mouyuhua/MFly/开题答辩问题.md

1. 选用NRF2401的优势在哪里

NRF2401的通信频段在2.4G，这个频段抗干扰能力强，可以远距离传输，最大传输距离可达10米。此外，NRF2401相比于其他通信，有着更好的安全性。所以选用NRF2401可以保证四轴飞行器的远距离安全飞行。

2. 为什么采用PWM的方式调节电机转速

利用PWM可以实现从处理器到被控系统号都是数字形式的，无需进行数模转换。让信号保持为数字形式可将噪声影响降到最小。从而可以更加精确的控制电机的转速，确保四轴飞行器飞行过程中保持平稳。

3. 为什么选用MPU9250，而不选用MPU6050

MPU6050是六轴传感器，包含了三轴加速度和三轴陀螺仪。而MPU9250相比于MPU6050多了三轴的磁力计。可以利用三轴磁力计可以更加精确的计算出四轴飞行器的状态。因此利用MPU9250比利用MPU6050来控制四轴更加有优势。
