mouyuhua/MFly/PCB_原理图/Project Outputs for Fly_Project/清单.xls

Comment | Description | Designator | Footprint | LibRef | Value
Type_c-16P |  | *1 | TYPE-C-16P | Type_c-16P
BAT | Header, 2-Pin | Battery1 | BAT | BAT
1uf |  | C1, C5, C6, C7, C8, C28, C29, C30, C31 | 0603P | C | 1uf
15pF |  | C2 | 0603P | C | 15pF
22uF |  | C3, C4, C9, C33 | 0603P | C | 22uF
10nF |  | C10, C22 | 0603P | C | 10nF
1nF |  | C11 | 0603P | C | 1nF
3.3nF |  | C12 | 0603P | C | 3.3nF
1.5pF |  | C13 | 0603P | C | 1.5pF
1pF |  | C14 | 0603P | C | 1pF
2.2nF |  | C15 | 0603P | C | 2.2nF
4.7pF |  | C16 | 0603P | C | 4.7pF
10pF |  | C17, C18 | 0603P | C | 10pF
0.1uF |  | C19, C20, C21, C23, C32, C34, C35, C36, C37, C38, C40 | 0603P | C | 0.1uF
10uF |  | C24, C25, C26, C27 | 0603P | C | 10uF
LED_0603 | 发光二极管 | D1, D4, D11 | LED-0603 | LED 0603
BAT54C | 表贴肖特基二极管 | D2 | SOT23-3M | BAT54C
DIODE | 普通二极管 | D3 | SMA/DO-214AC | DIODE
1N4148 |  | D5, D6, D7, D8 | DIODE_SOP | D
P923D |  | D9, D10, D12, D13 | RGB_LED_5050 | P923D
ANT |  | E1 | ANT | ANT
LTC4054ES5-4.2 | 锂电池充电芯片 | IC1 | SOT23-5M | LTC4054
Pin HDR1X8 |  | J1, J2 | Pin HDR1X8/2.54mm-S | Pin HDR1X8
INDUCTOR | INDUCTOR | L1 | AL0204 | INDUCTOR
INDUCTOR | INDUCTOR | L2, L3, L4 | 0402L | INDUCTOR
Motor_720 | Motor, General Kind | M1, M2, M3, M4 | MOTOR | Motor_720
Header 1 |  | P1, P2, P3, P4, P5 | HEADER1 | Header 1
Header 4 | Header, 4-Pin | P6 | HDR1X4 | Header 4
SI2302 | N-Channel Power MOSFET | Q1, Q2, Q3, Q4 | SOT23-3M | SI2302
AO3401 | MOS管_P沟道 | Q5 | SOT23-3M | MOSFET-P
SS9013 | 8050/BCW846/BCW847 | Q6 | SOT-23R | NPN
2.2K |  | R1 | 0603P | R | 2.2K
1K |  | R2, R18, R19, R22, R23 | 0603P | R | 1K
22R |  | R3, R6 | 0603P | R | 22R
4.7K |  | R4, R10, R16, R17 | 0603P | R | 4.7K
10K |  | R5, R9, R20, R21, R24, R25, R27, R29, R33, R34, R35, R36 | 0603P | R | 10K
73.2K |  | R7 | 0603P | R | 73.2K
100K |  | R8, R11, R12, R30, R31, R32 | 0603P | R | 100K
22K |  | R13 | 0603P | R | 22K
0 |  | R14, R15, R26, R28 | 0603P | R | 0
KEY_M |  | RESET? | KEY_M | KEY_M
SW-SPDT | SPDT Subminiature Toggle Switch, Right Angle Mounting, Vertical Actuation | S1 | SWITCH_PWR | SW-SPDT
SX1308 | 可调升压芯片 | U1 | SOT23-6 | SX1308
XC6206 |  | U2, U3 | SOT23-3M | XC6206
nRF24L01 |  | U4 | QFN20 | nRF24L01
FBM320\BMP280\SPL06 | 气压计 | U5, U7 | LGA-2_5X2MM | FBM320
MPU9250 | MPU9250 | U6 | QFN24-0.4 | MPU9250
ESP8266 |  | U8 | ESP_12 | ESP8266
STM32F103C8T6 |  | U9 | LQFP48 7X7 | STM32F103C8T6
XTAL | XTAL16M | XTAL1 | SMD-3225_4P | XTAL16M | 16MHz
XTAL |  | Y1 | SMD-cstse800G52-r0 | XTAL_2 | 8MHz
