mouyuhua/MFly/(list of files, cad)

Other CAD files:
PCB_原理图/mfly_shape.dwg
