mouyuhua/MFly/PCB_原理图/Project Outputs for Fly_Project/MFly.pdf

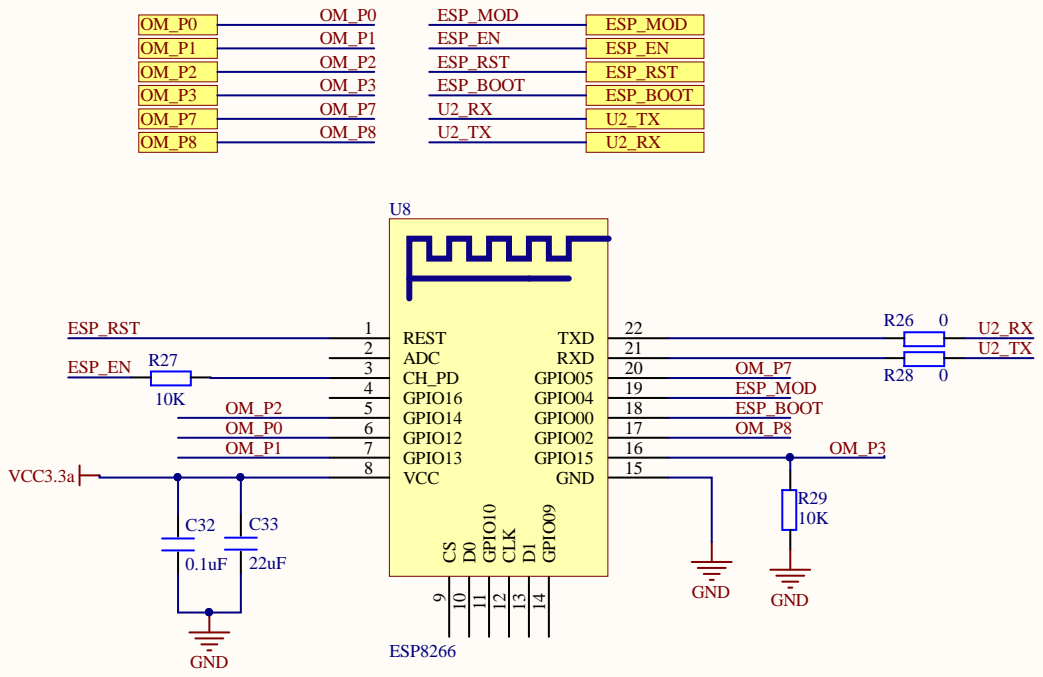
[picture p4: page 1]

GPIO13 7
VCC 8

Title | Altium Limited L3, 12a Rodborough Rd Frenchs Forest NSW Australia 2086

Size: A3 | Number: | Revision:
Date: 2022/4/23 Time: 13:10:14 | | Sheet of

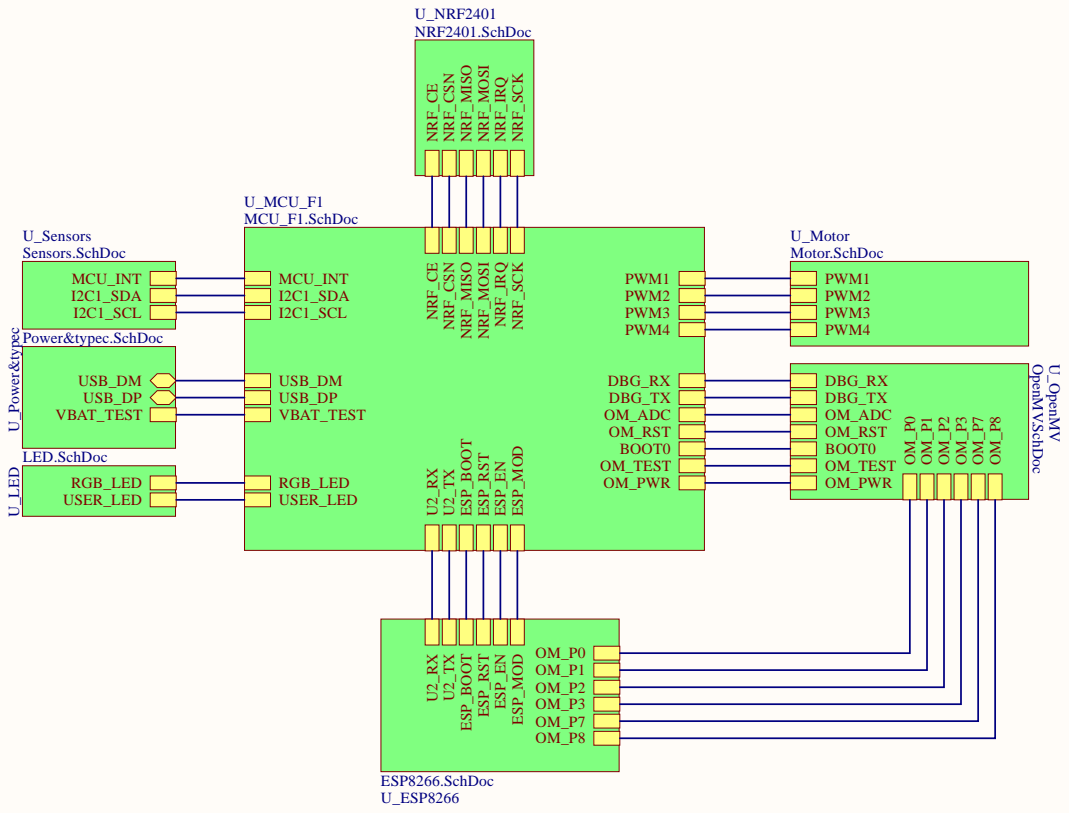
[picture p5: page 2]

U_Power&typec Power&typec.SchDoc

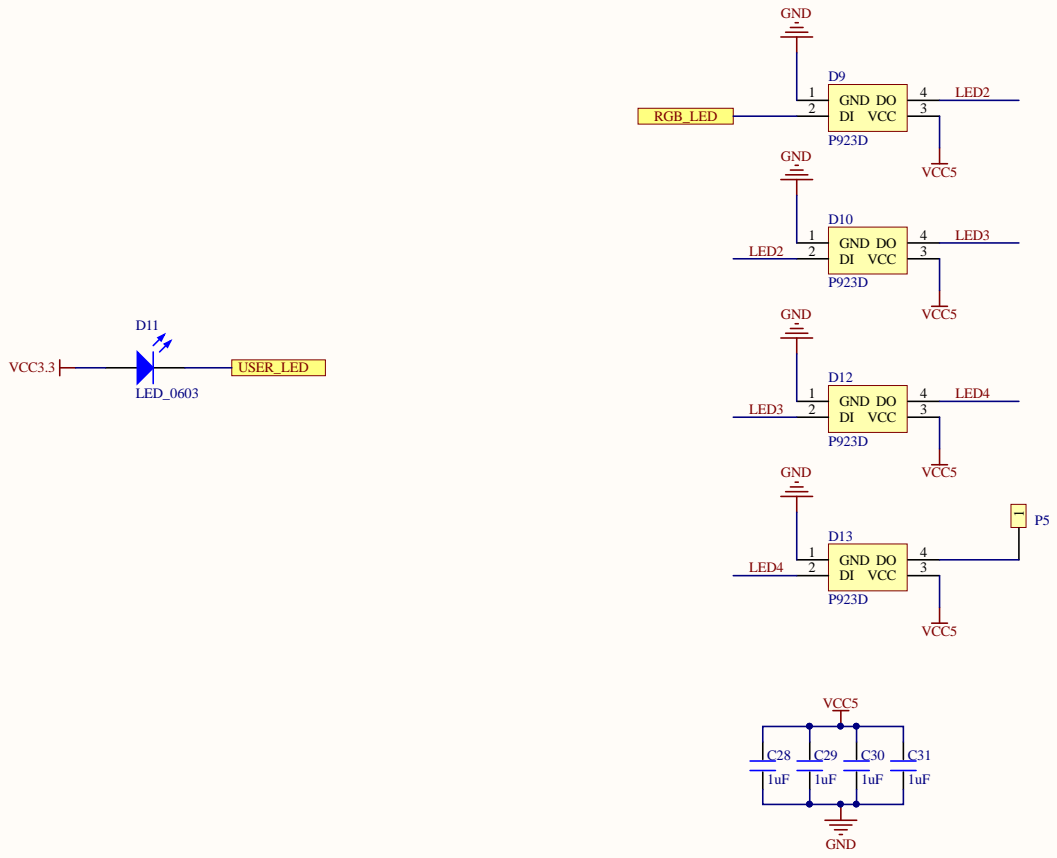
[picture p6: page 3]

Australia 2086

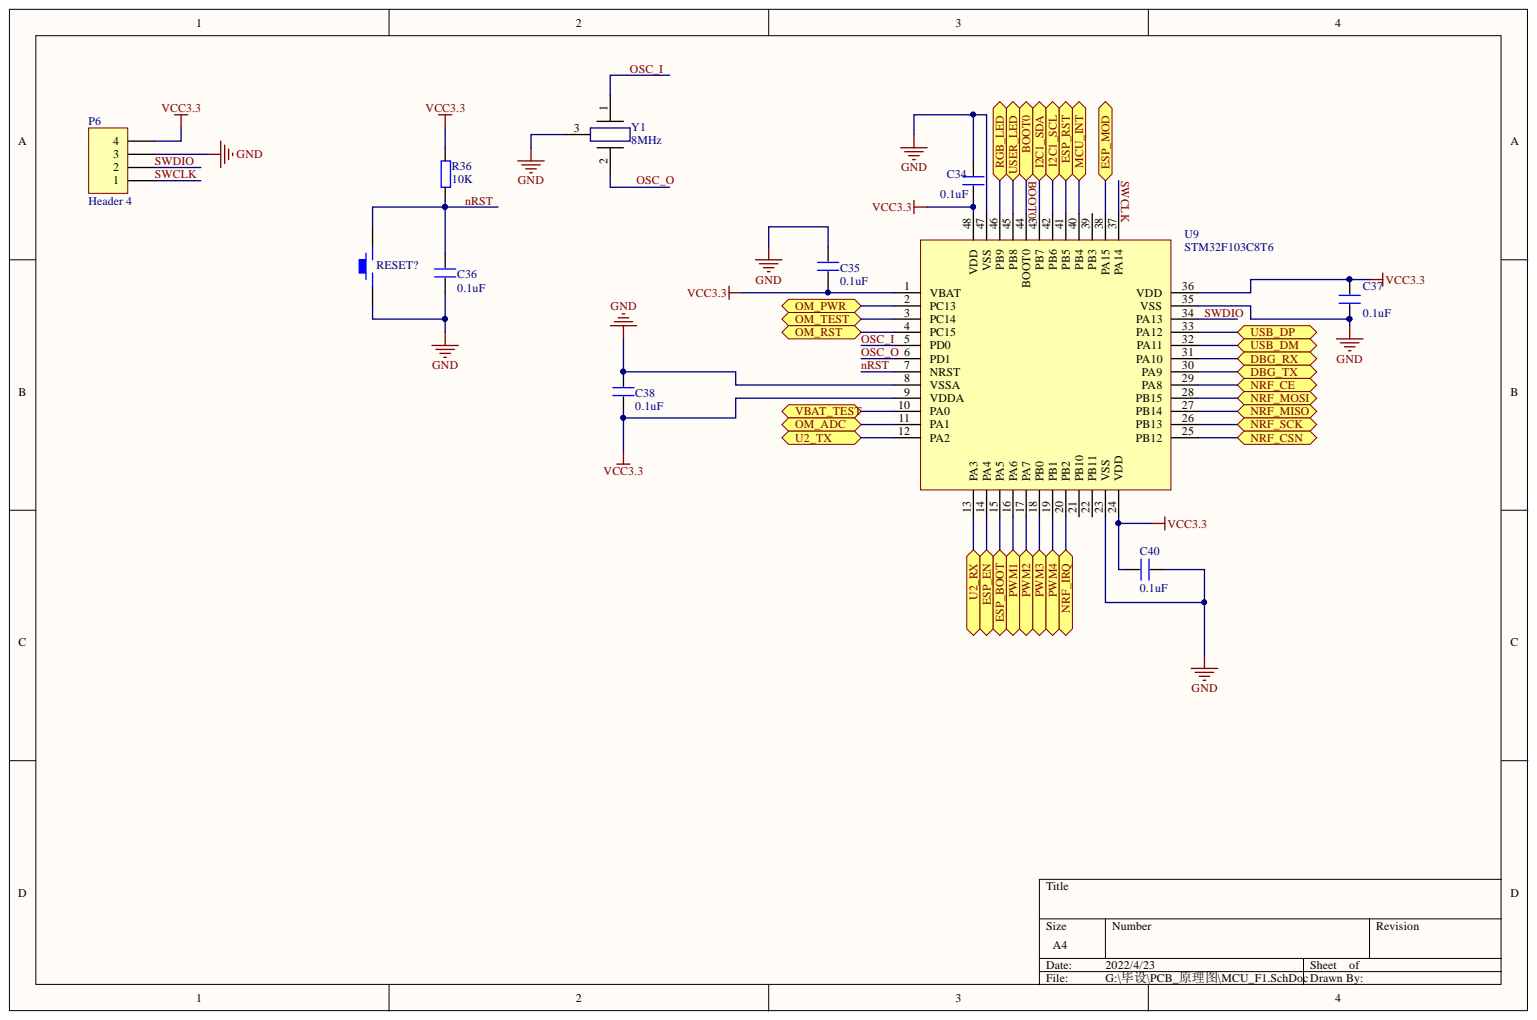
[picture p7: page 4]

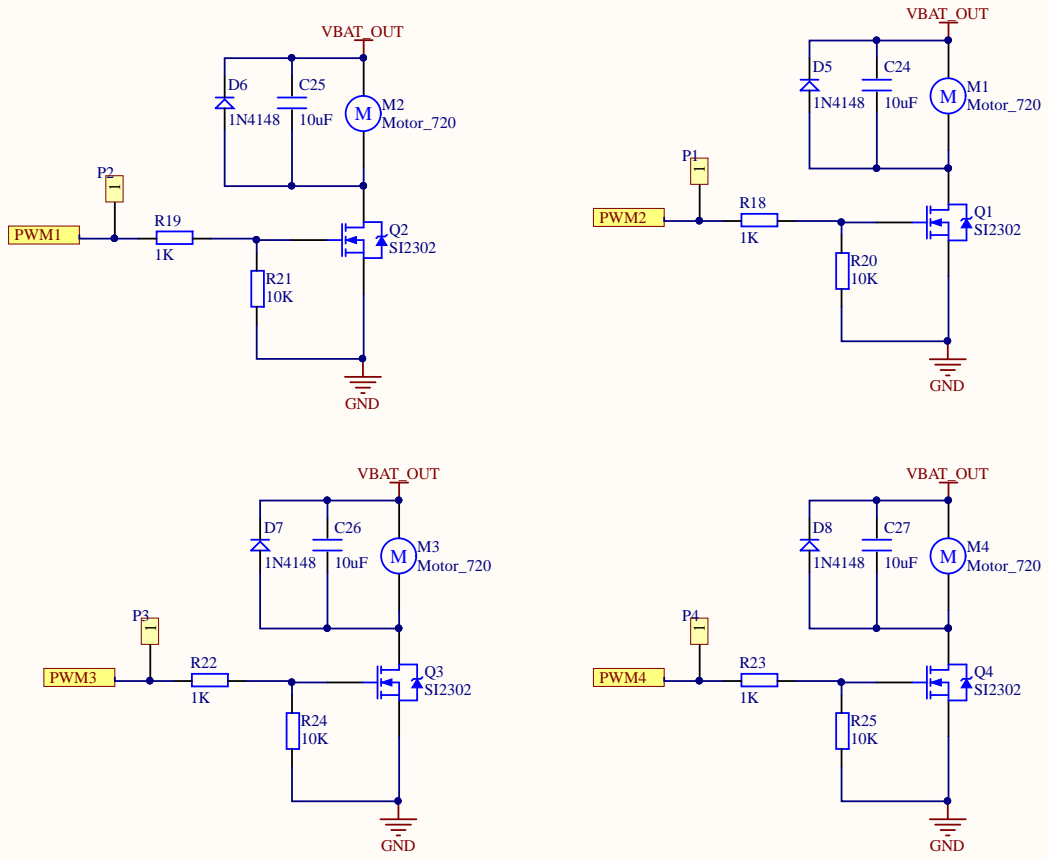
[picture p8: page 5]

Australia 2086

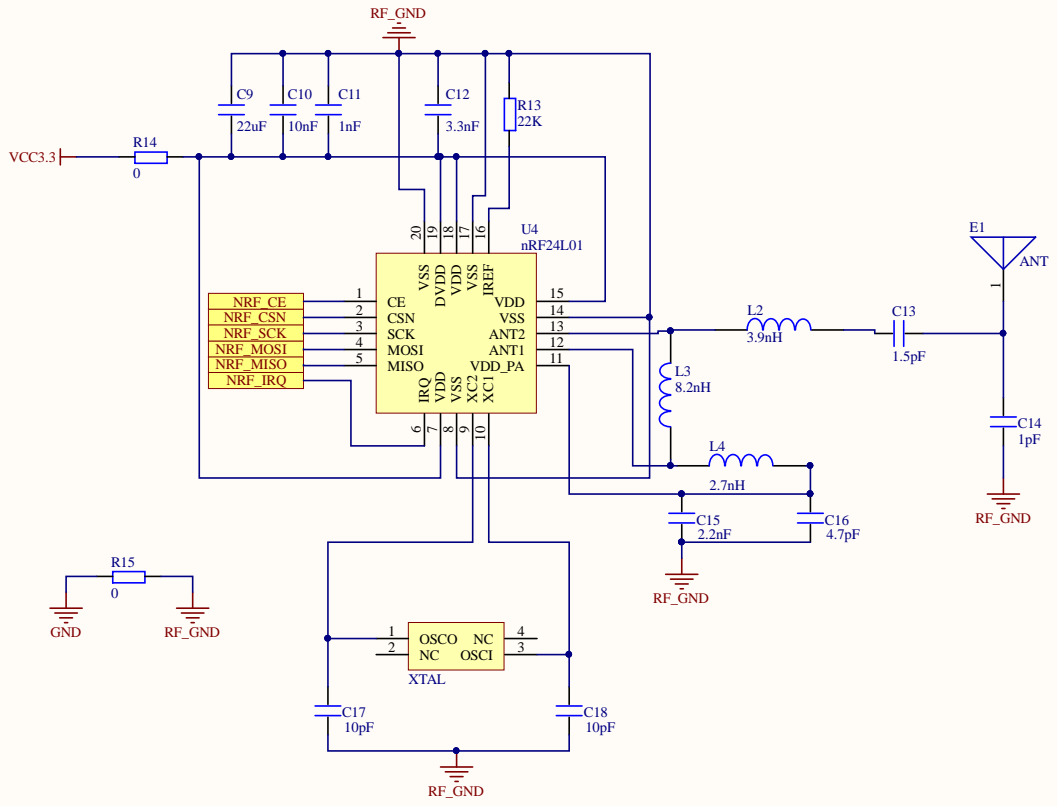
[picture p9: page 6]

15 REF 16 VSS 17 VDD 18 DVDD 19 VSS 20

NRF_CE | CSN 2

Australia 2086

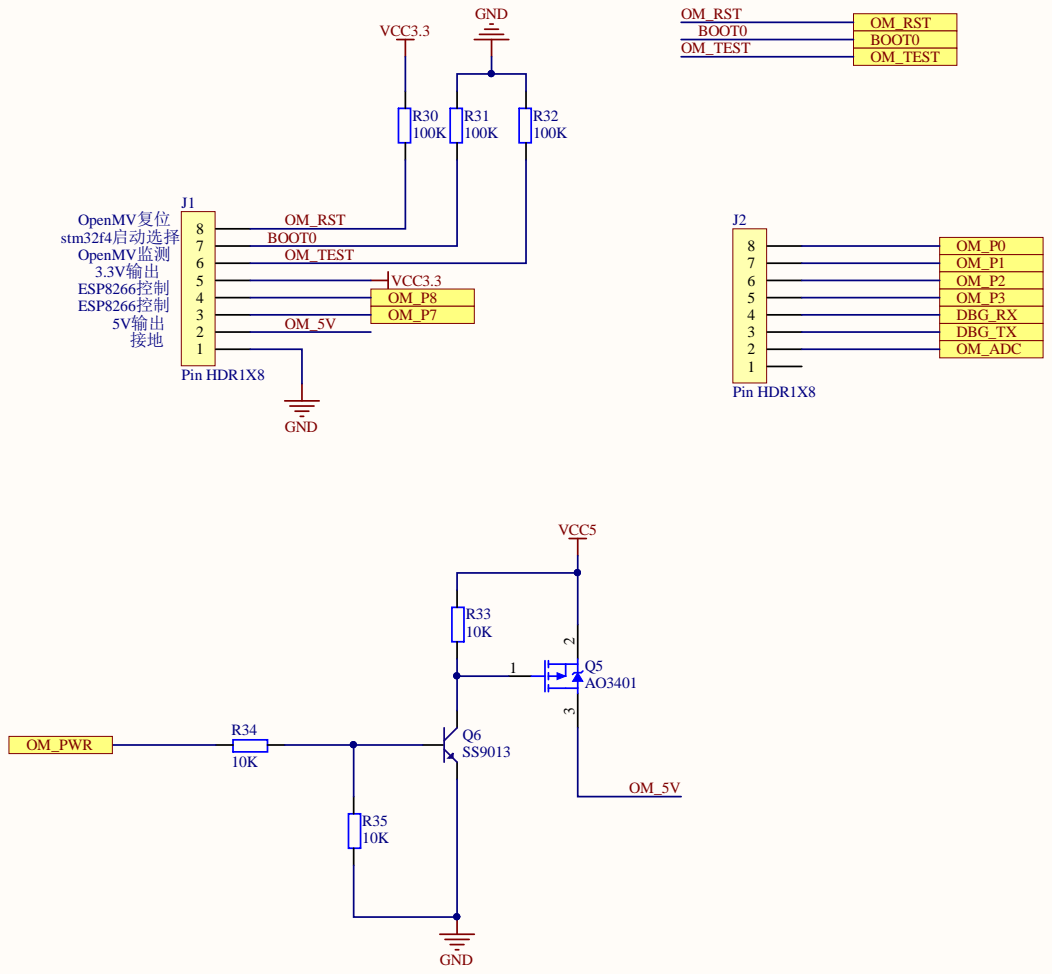
[picture p10: page 7]

VCC3.3 | OM_P1

Australia 2086

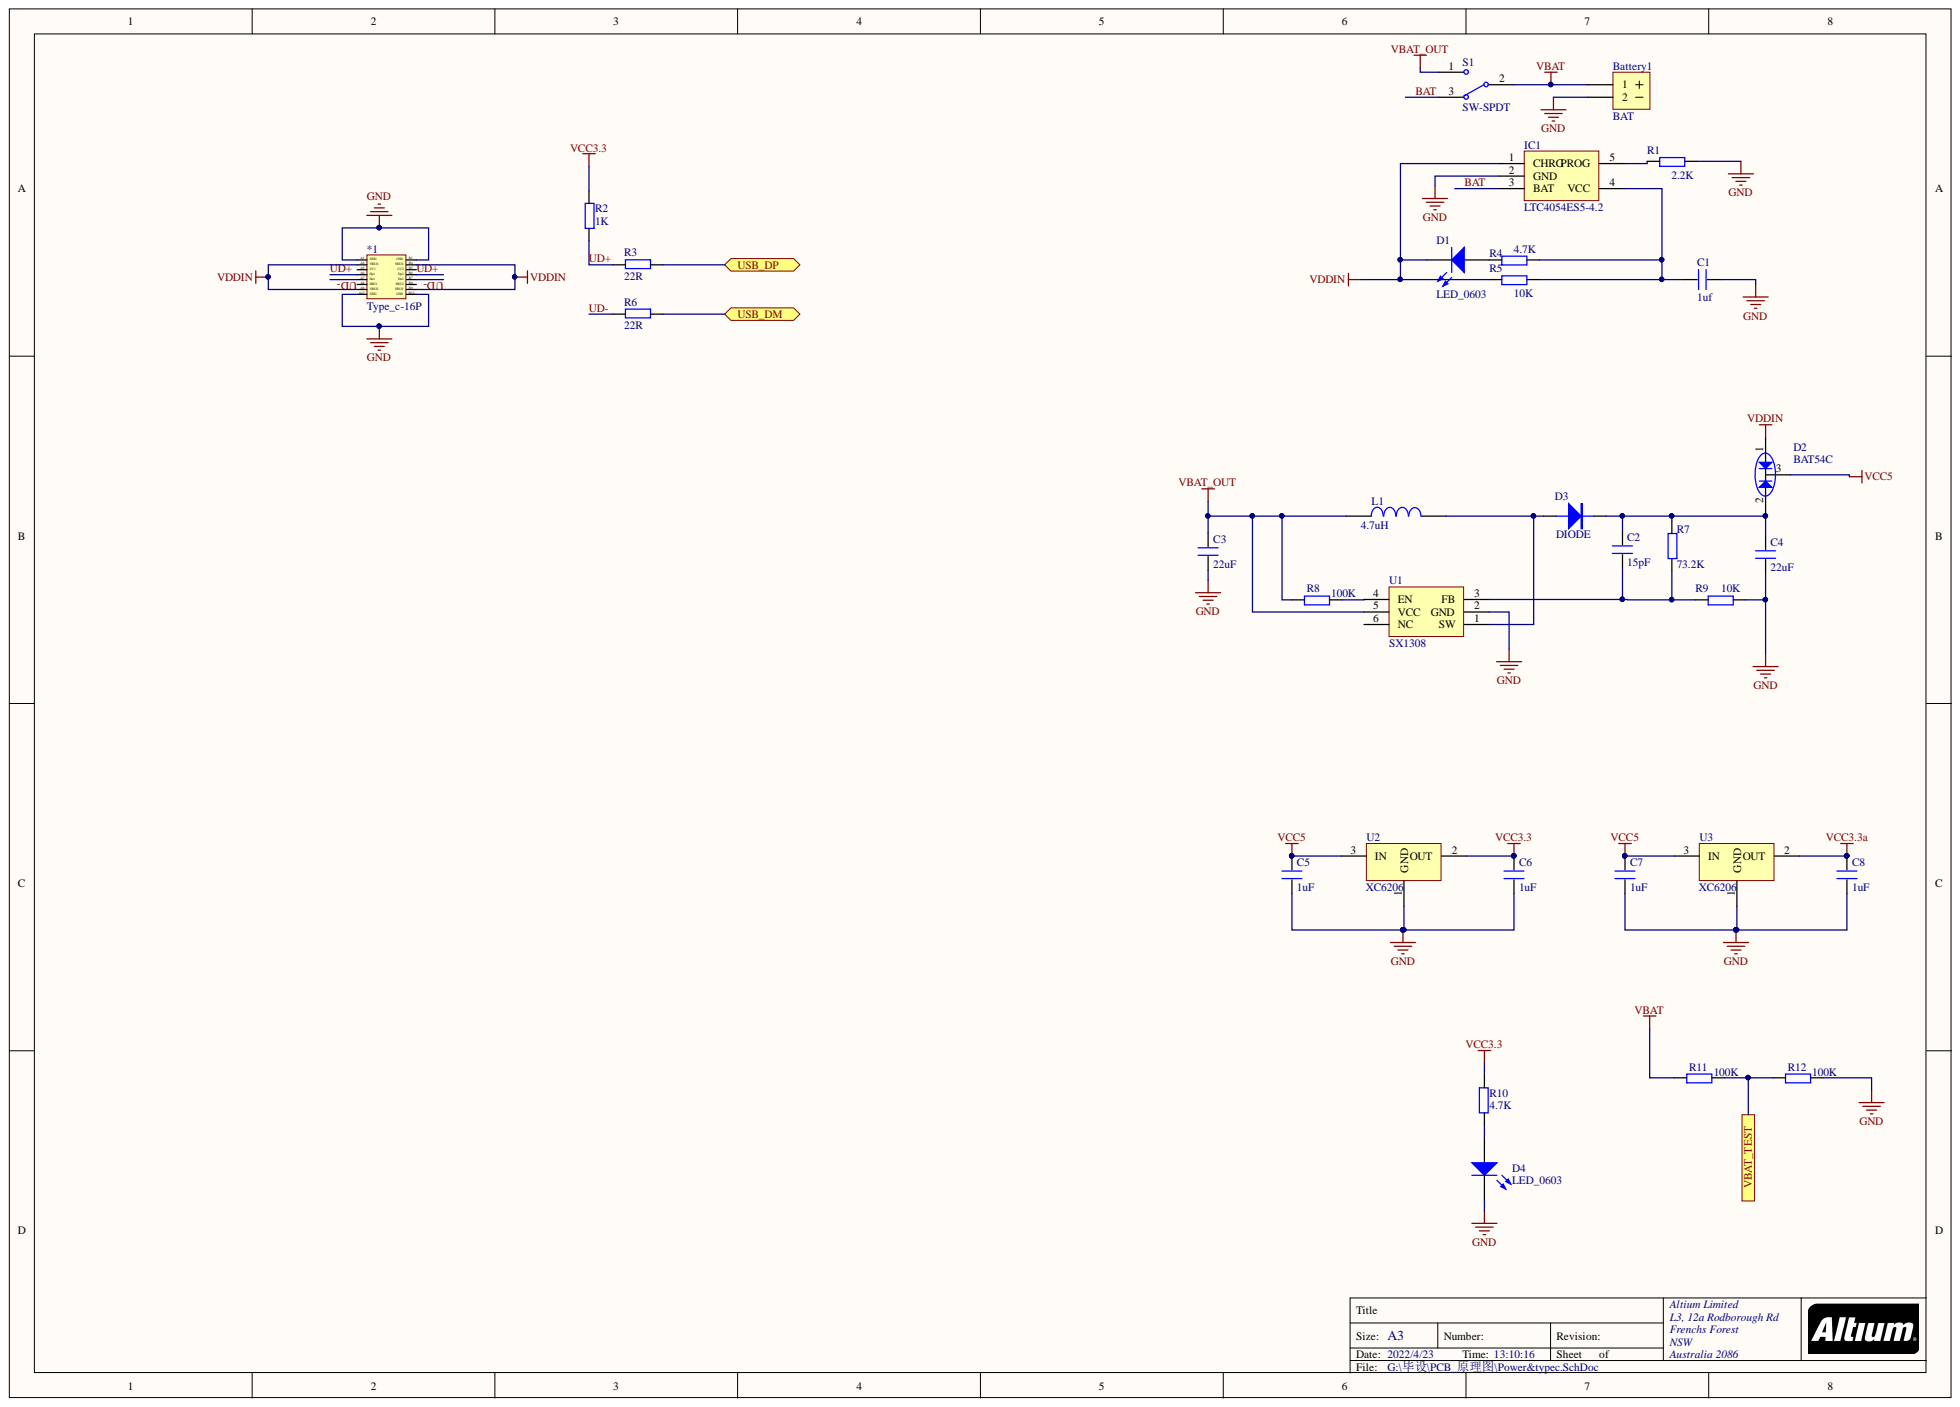
[picture p11: page 8]

BAT

GND 2

Australia 2086

G:\毕设\PCB_原理图\Power&typec.SchDoc

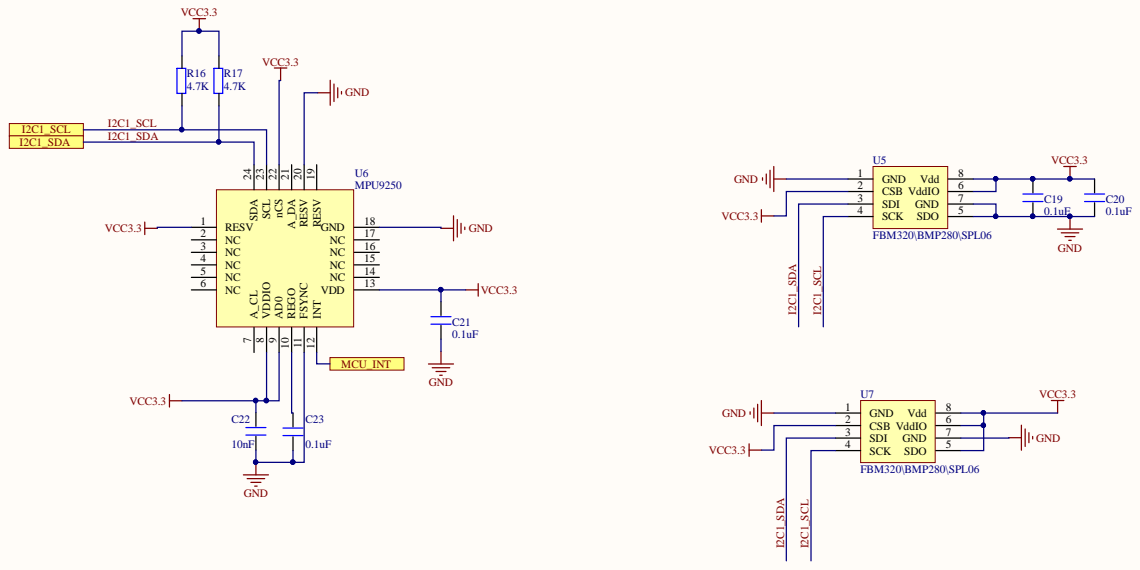
[picture p12: page 9]

ESV 19 RESV 20 A_DA 21 nCS 22 SCL 23 SDA 24

3 | | 7 5

Ti t l e | A l t ium Li m i ted L3, 12a Rodborough R d Frenchs Fores t Aus t ral ia 2086

Size: A | Number : | Revi s ion:
2022/4/23 Ti me: 13:10:17 | | Sheet of

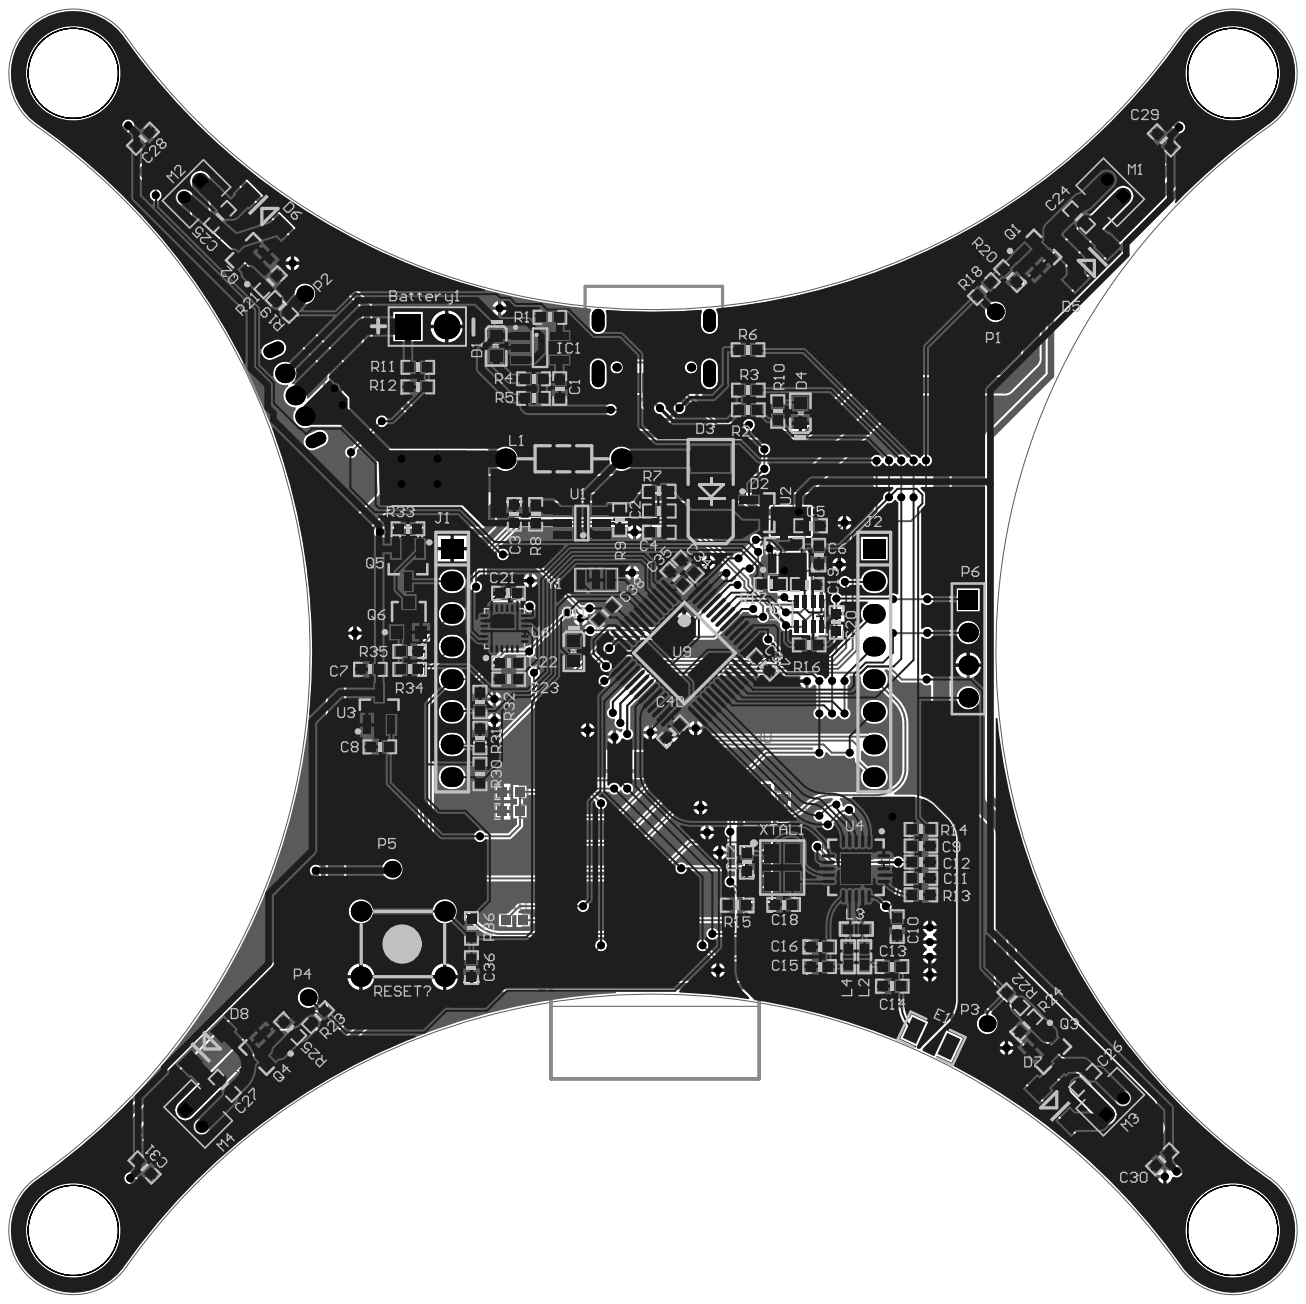
[picture p13: page 10]
