mouyuhua/MFly/PCB_原理图/Project Outputs for Fly_Project/标号.pdf

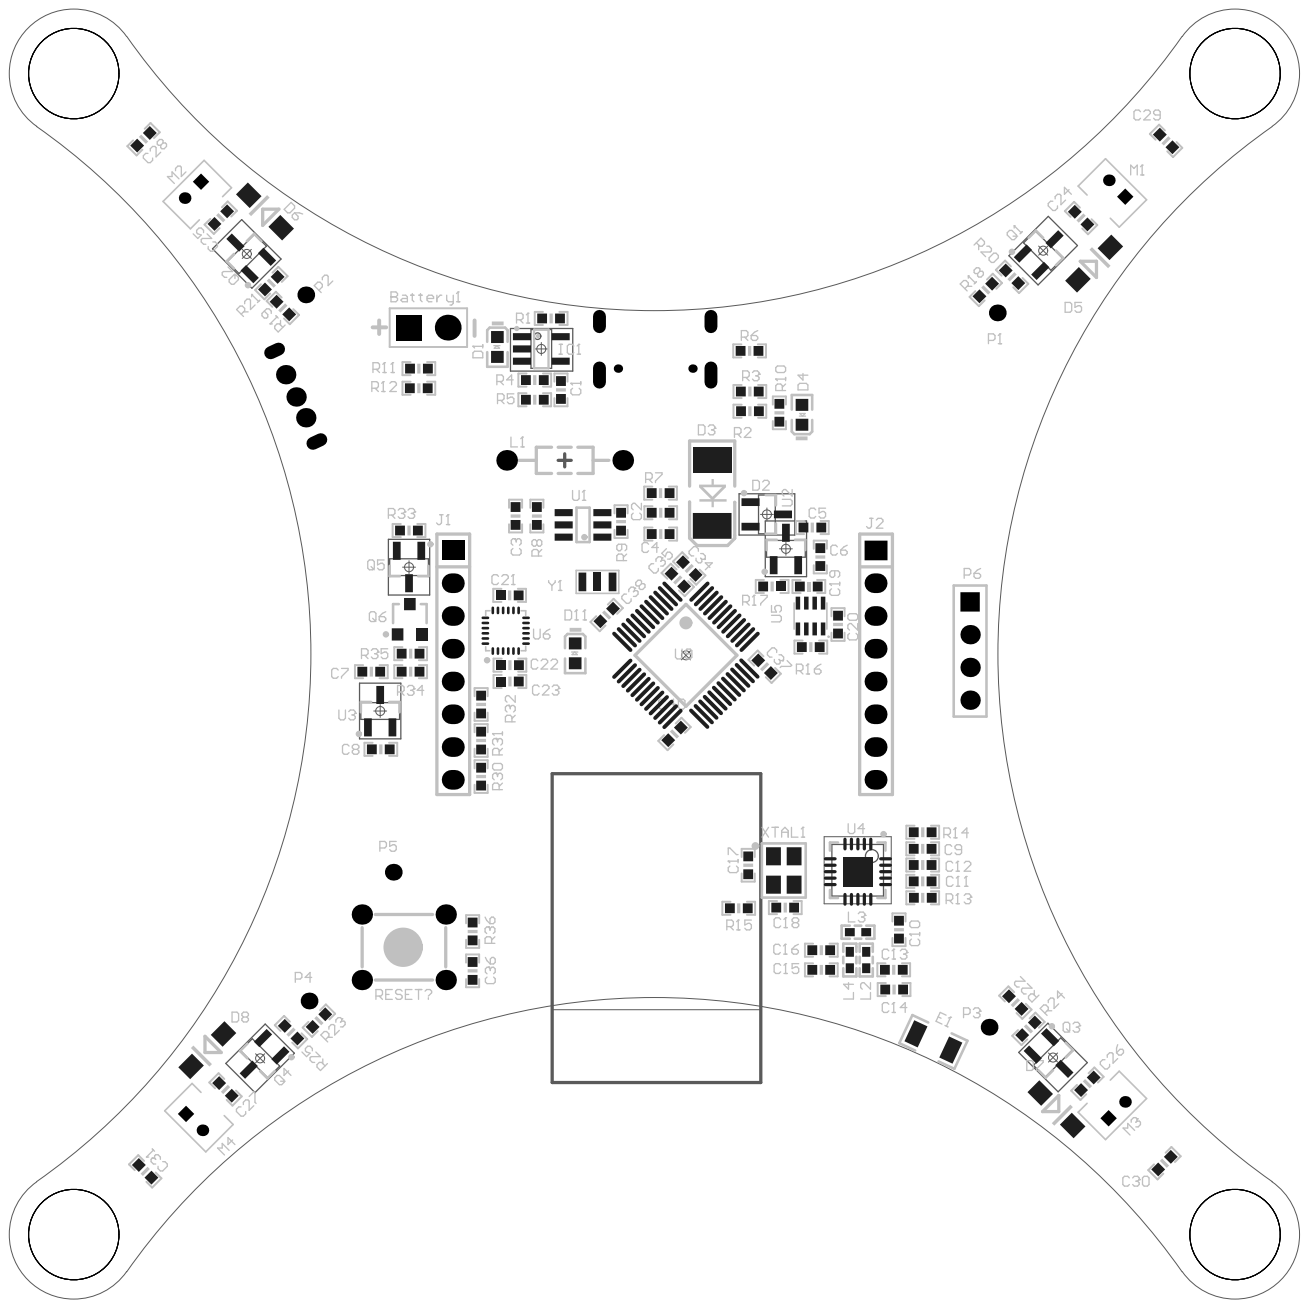
[picture p14: page 1]

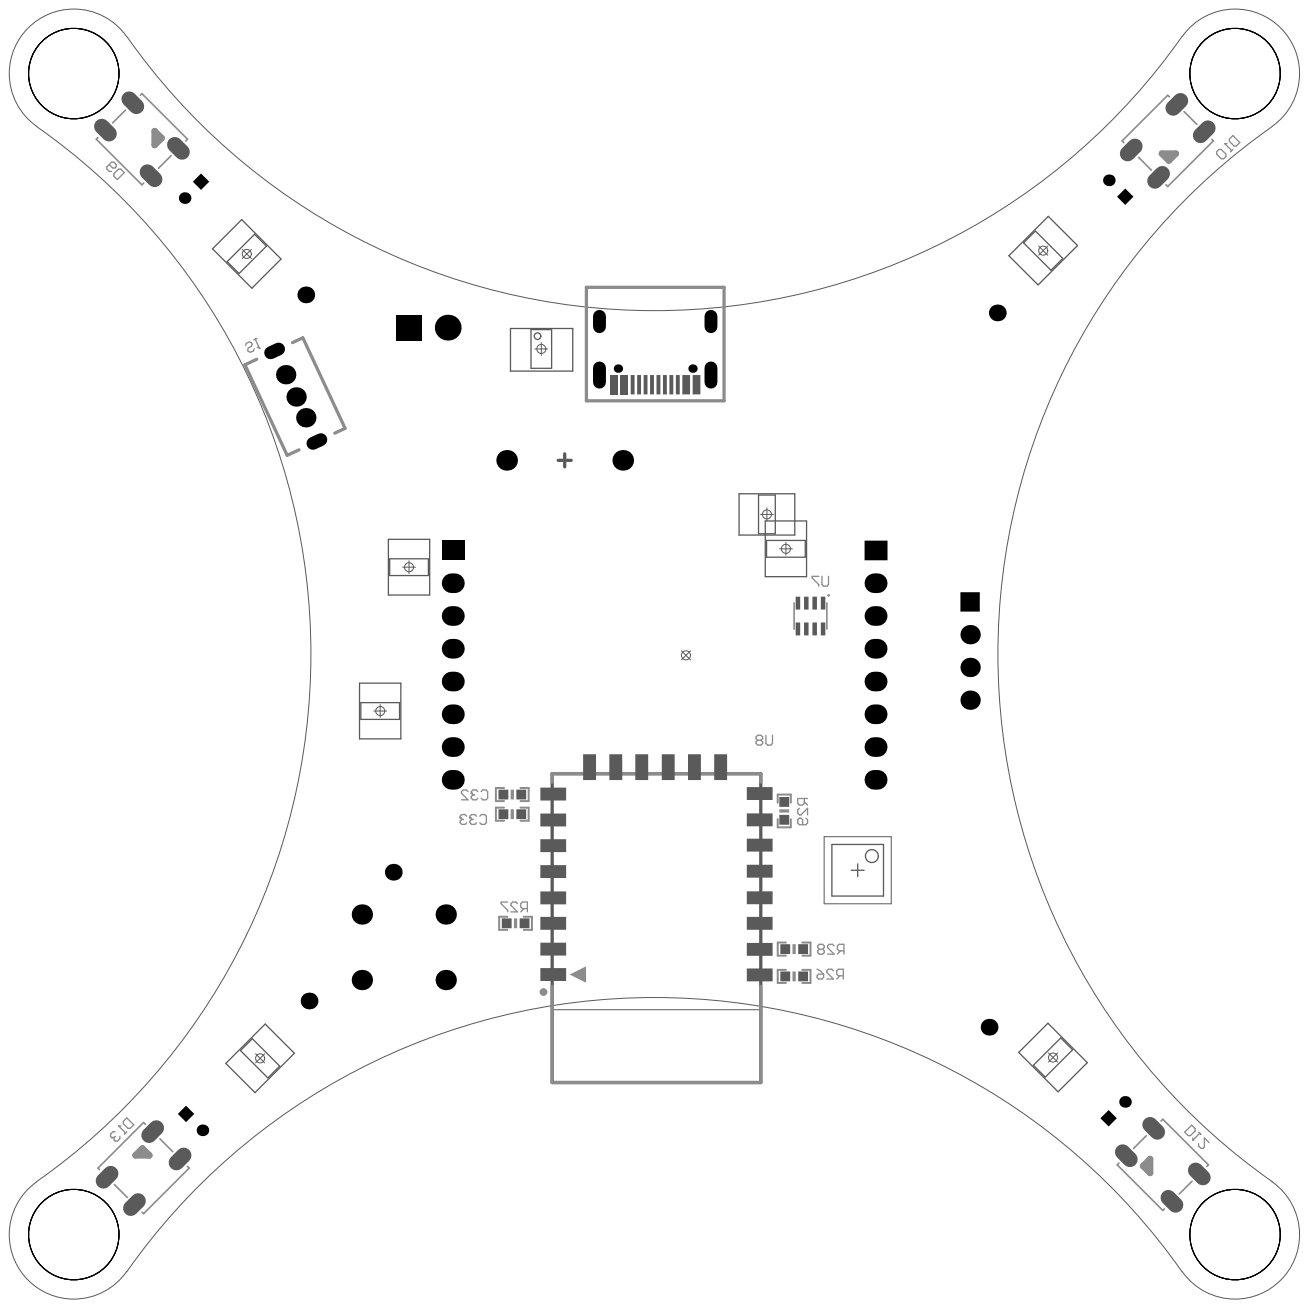
[picture p15: page 2]
