mouyuhua/MFly/(list of files, drawings)

Other design files:
PCB_原理图/ESP8266.SchDoc
PCB_原理图/Fly.SchDoc
PCB_原理图/Fly_Project.PrjPcb
PCB_原理图/LED.SchDoc
PCB_原理图/MCU.SchDoc
PCB_原理图/MCU_F1.SchDoc
PCB_原理图/Motor.SchDoc
PCB_原理图/NRF2401.SchDoc
PCB_原理图/OpenMV.SchDoc
PCB_原理图/Power&typec.SchDoc
PCB_原理图/Sensors.SchDoc
