mouyuhua/MFly/(commit log)

2022-04-21 四轴pcb及原理图
    [ESP8266.SchDoc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]
2022-04-21 答辩材料
2022-04-23 工程输出文件
    [ESP8266.SchDoc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]
2022-04-23 mfly外形图
    [mfly_shape.dwg, 清单.xls]
